ntu-hci-lab/SpinShot/README.md

# SpinShot

<div style="background-color: white; text-align: center;">
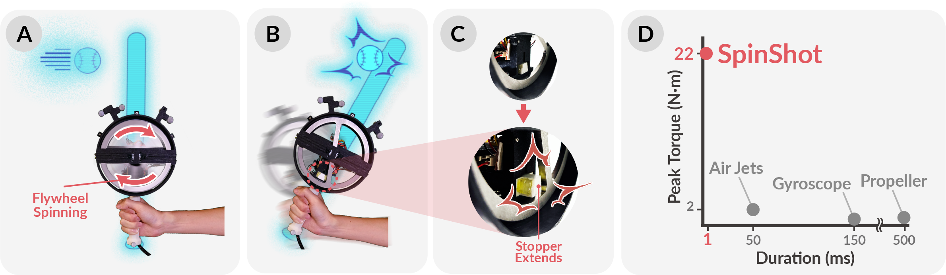
[picture p1: figures/Teaser.png]
    
</div>
