ntu-hci-lab/SpinShot/00_Hardware/Circuit/SpinShot_Circuit.png

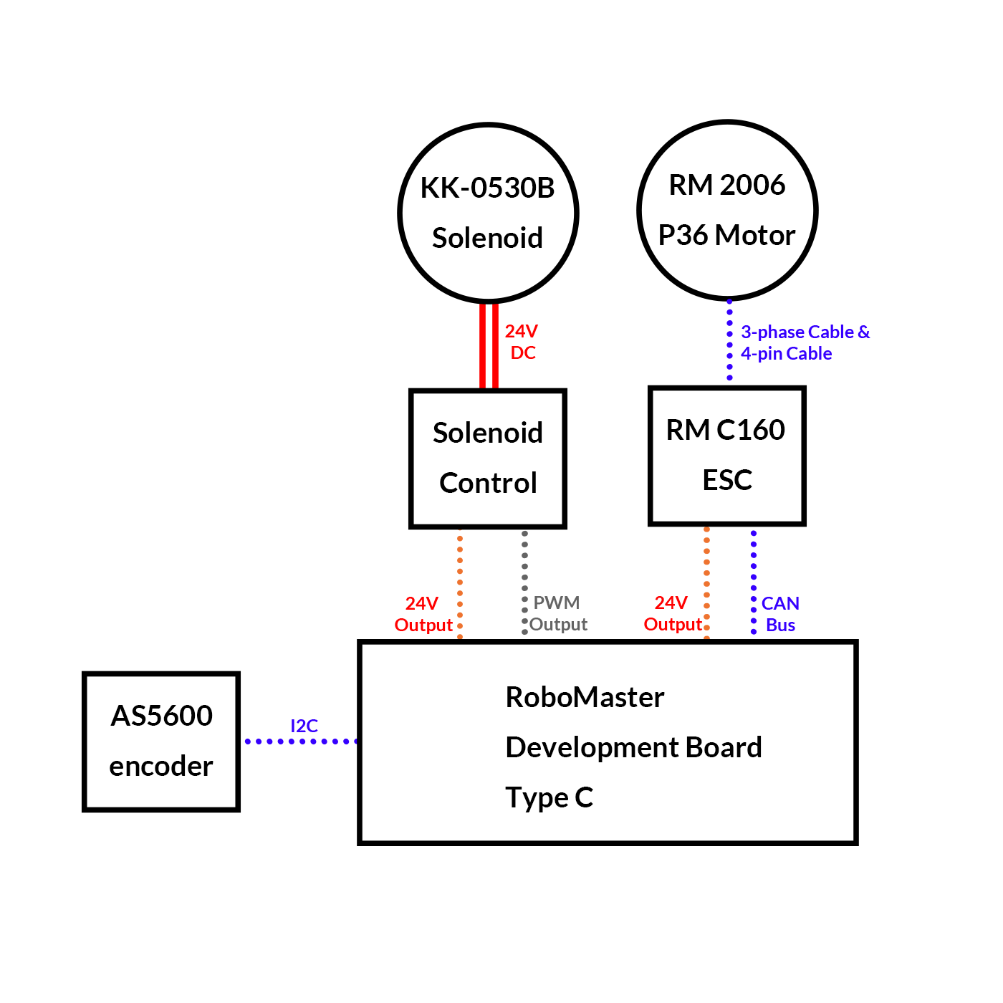
00_Hardware/Circuit/SpinShot_Circuit.png
