ntu-hci-lab/SpinShot/figures/Explosion.png

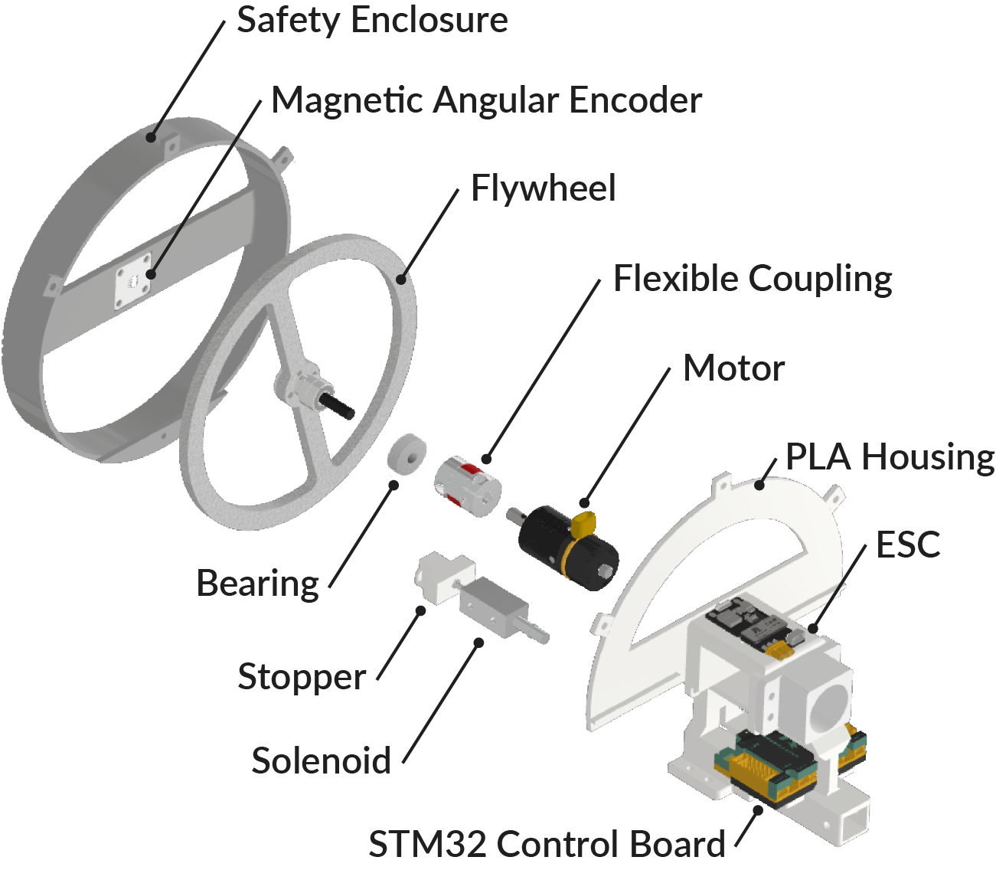
figures/Explosion.png
