ntu-hci-lab/SpinShot/00_Hardware/3D_Models/body/body.stl

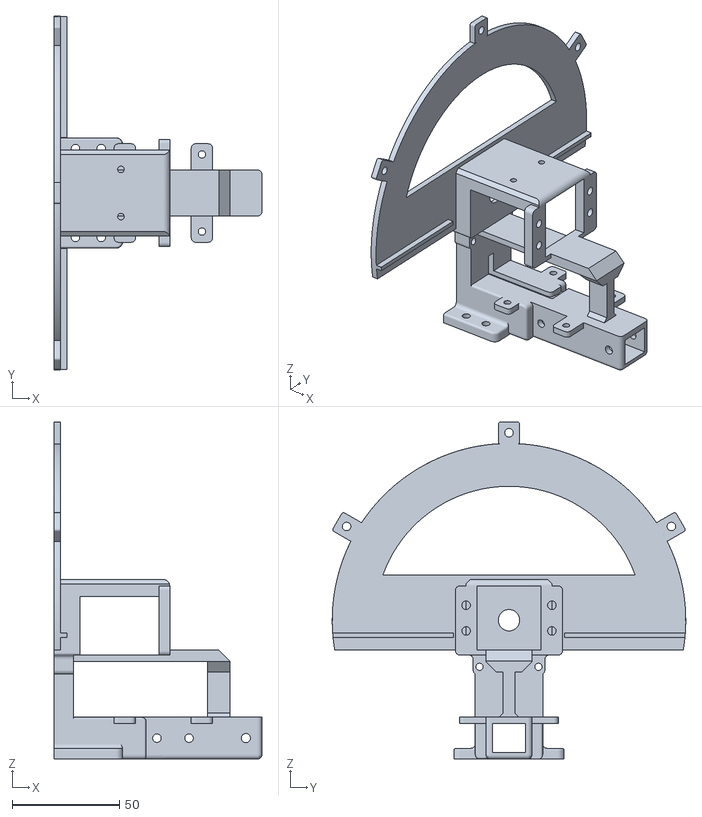
[picture p7: CAD file, 2024-06-13]
00_Hardware/3D_Models/body/body.stl
97.0 x 165.0 x 157.2
