ntu-hci-lab/SpinShot/00_Hardware/3D_Models/flywheel/flywheel_15cm.stl

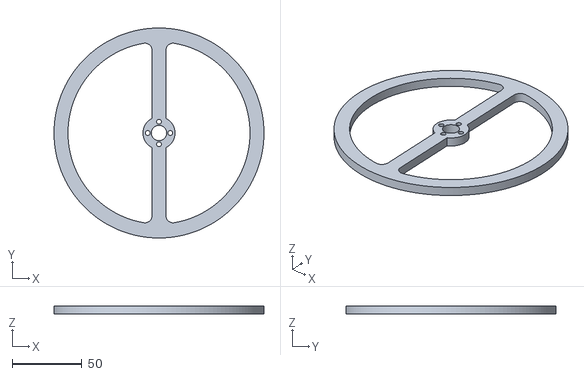
[picture p8: CAD file, 2024-06-13]
00_Hardware/3D_Models/flywheel/flywheel_15cm.stl
150.0 x 150.0 x 6.00
