ntu-hci-lab/SpinShot/00_Hardware/3D_Models/handle/long/handle_long.stl

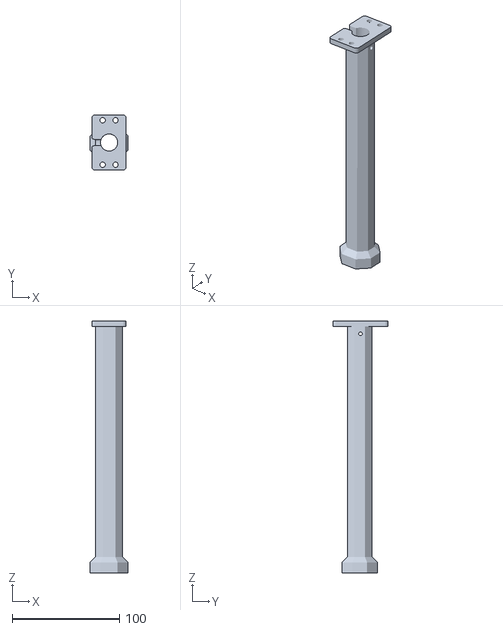
[picture p9: CAD file, 2024-06-13]
00_Hardware/3D_Models/handle/long/handle_long.stl
35.2 x 51.5 x 235.0
