ntu-hci-lab/SpinShot/00_Hardware/3D_Models/handle/short/handle_short.stl

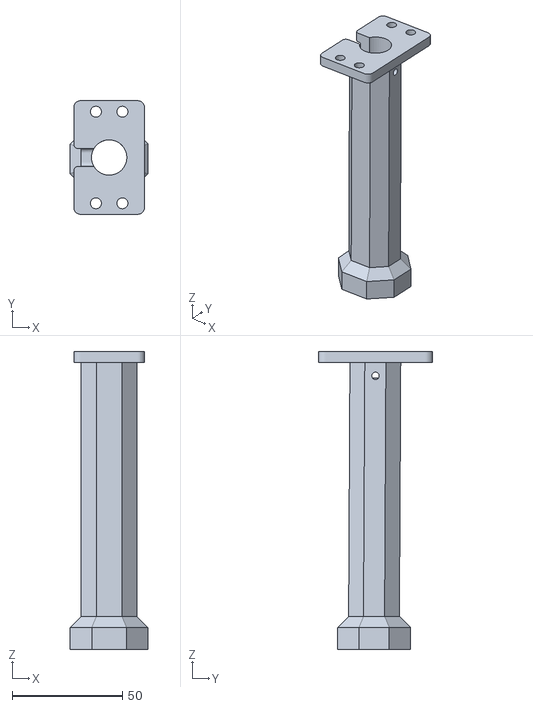
[picture p10: CAD file, 2024-06-13]
00_Hardware/3D_Models/handle/short/handle_short.stl
35.2 x 51.5 x 135.0
