ntu-hci-lab/SpinShot/00_Hardware/3D_Models/safty_enclosure/original/safty_enclosure.stl

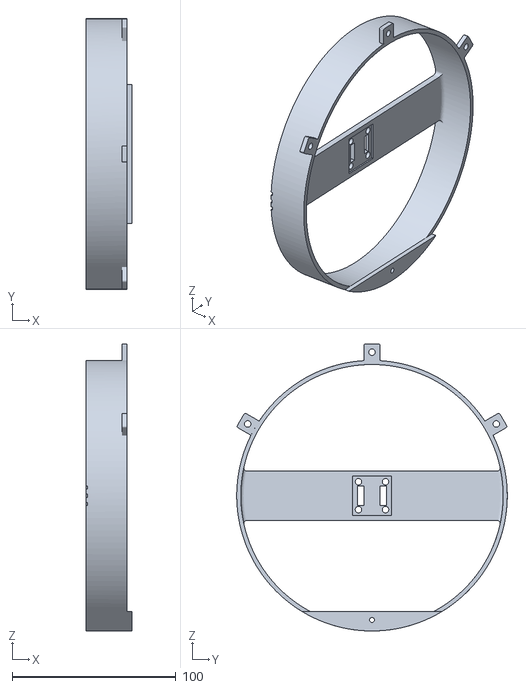
[picture p11: CAD file, 2024-06-13]
00_Hardware/3D_Models/safty_enclosure/original/safty_enclosure.stl
28.0 x 165.0 x 175.0
