ntu-hci-lab/SpinShot/00_Hardware/3D_Models/safty_enclosure/with_optiTrack_markers/enclosure_with_OptiTrack_markers.stl

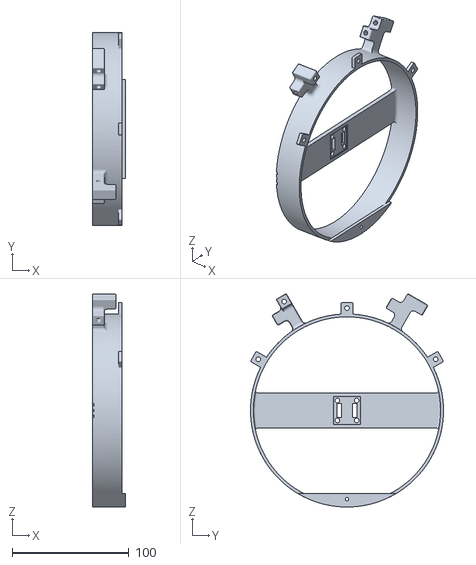
[picture p12: CAD file, 2024-06-13]
00_Hardware/3D_Models/safty_enclosure/with_optiTrack_markers/enclosure_with_OptiTrack_markers.stl
28.0 x 165.0 x 182.1
