ntu-hci-lab/SpinShot/00_Hardware/3D_Models/stopper/stopper.stl

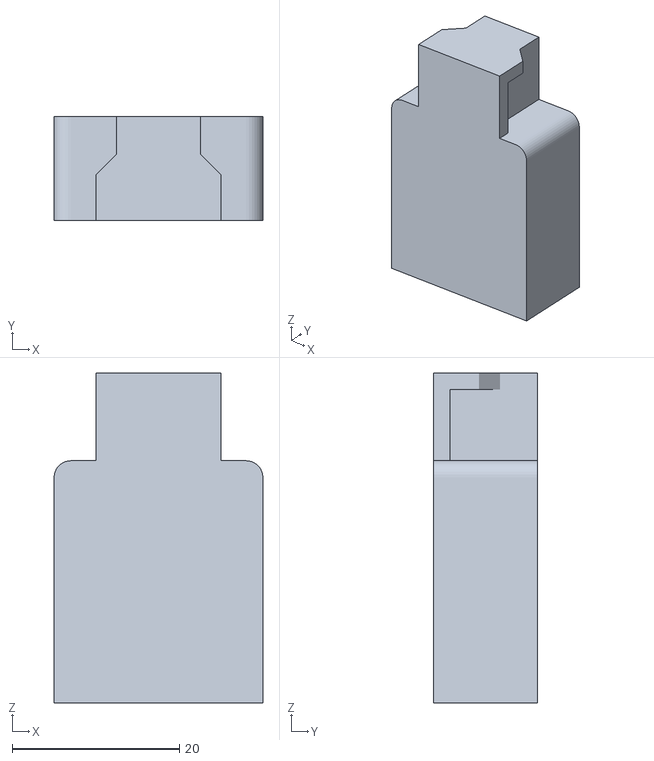
[picture p13: CAD file, 2024-06-13]
00_Hardware/3D_Models/stopper/stopper.stl
25.0 x 12.5 x 39.5
