ntu-hci-lab/SpinShot/(list of files, cad)

Other CAD files:
00_Hardware/3D_Models/body/Body.f3d
00_Hardware/3D_Models/body/Body.ipt
00_Hardware/3D_Models/flywheel/FLYWHEEL_15CM.DWG
00_Hardware/3D_Models/handle/long/handle_long.f3d
00_Hardware/3D_Models/handle/long/handle_long.ipt
00_Hardware/3D_Models/handle/short/handle_short.f3d
00_Hardware/3D_Models/handle/short/handle_short.ipt
00_Hardware/3D_Models/safty_enclosure/original/safty_enclosure.f3d
00_Hardware/3D_Models/safty_enclosure/original/safty_enclosure.ipt
00_Hardware/3D_Models/safty_enclosure/with_optiTrack_markers/enclosure_with_OptiTrack_markers.f3d
00_Hardware/3D_Models/safty_enclosure/with_optiTrack_markers/enclosure_with_OptiTrack_markers.ipt
00_Hardware/3D_Models/stopper/stopper.f3d
00_Hardware/3D_Models/stopper/stopper.ipt
