ntu-hci-lab/SpinShot/00_Hardware/3D_Models/flywheel/Flywheel.pdf

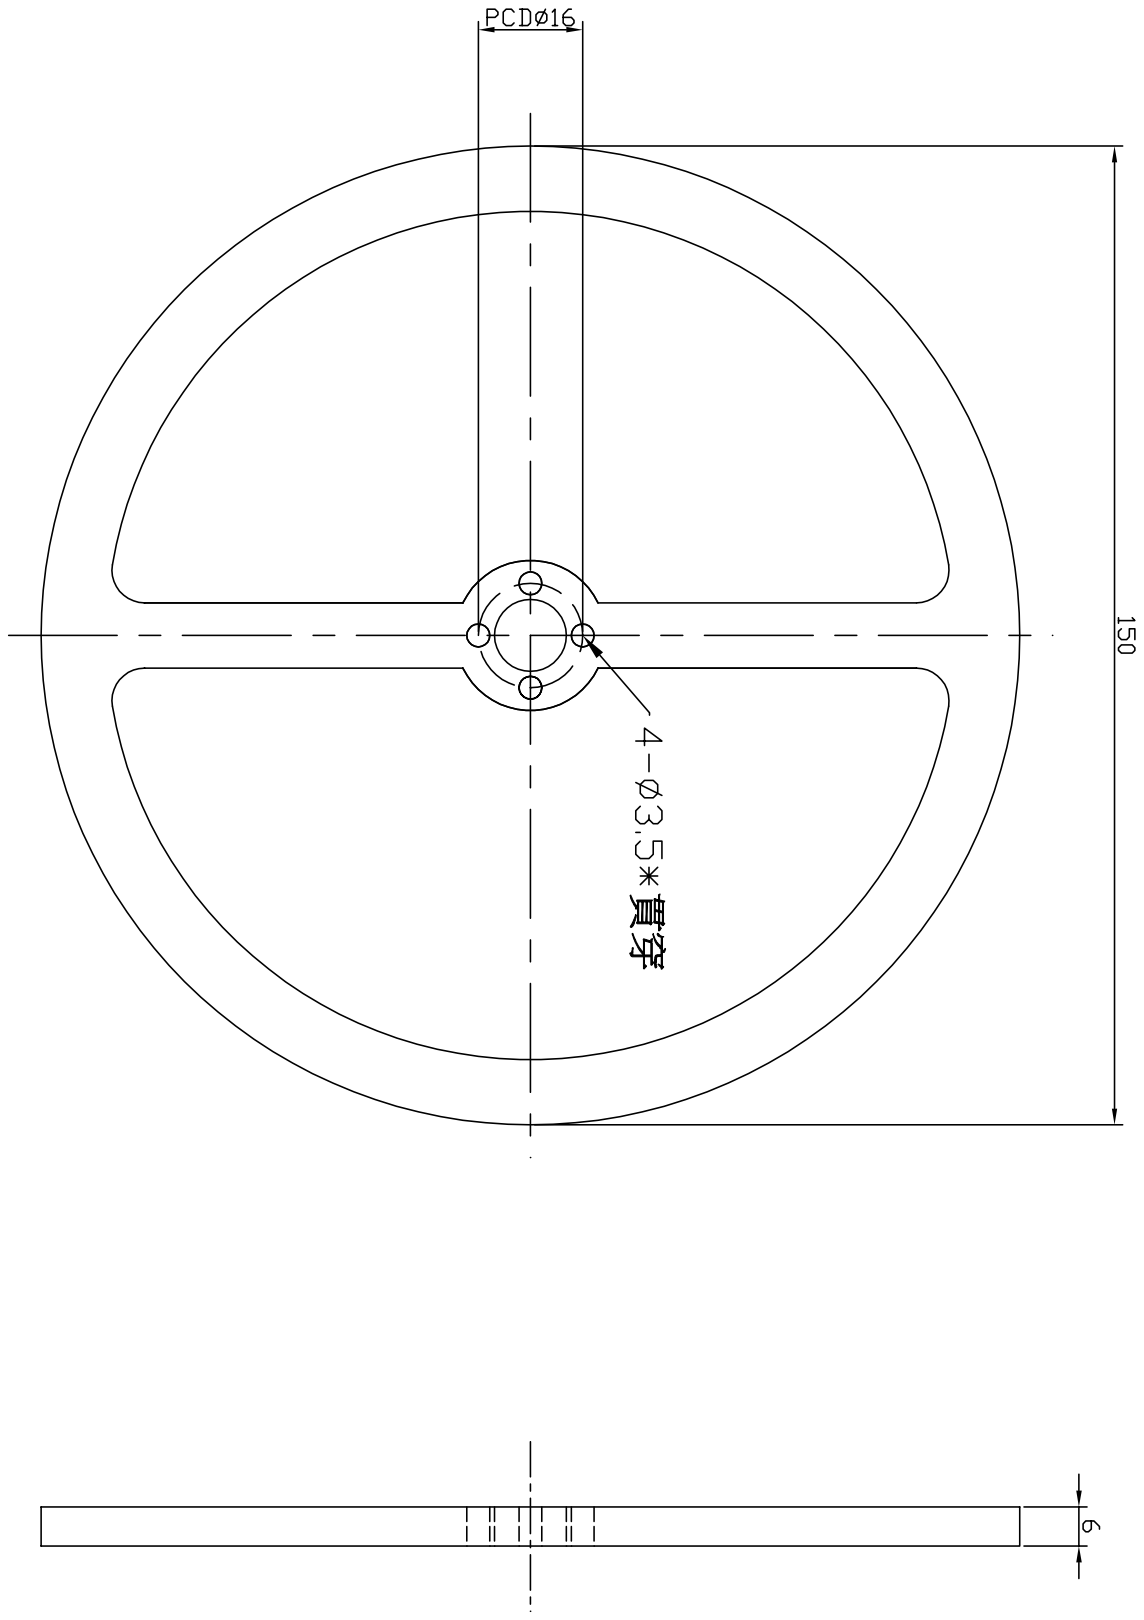
[picture p14: page 1]
