ntu-hci-lab/SpinShot/01_Firmware_STM32/SpinShot_STM32/SpinShot.ioc

Mcu.UserName=STM32F407IGHx
PA11.Signal=USB_OTG_FS_DM
PA12.Signal=USB_OTG_FS_DP
PA13.Signal=SYS_JTMS-SWDIO
PA14.Signal=SYS_JTCK-SWCLK
PC6.Signal=S_TIM8_CH1
PD0.Signal=CAN1_RX
PD1.Signal=CAN1_TX
PE11.Signal=S_TIM1_CH2
PE13.Signal=S_TIM1_CH3
PE14.Signal=S_TIM1_CH4
PE9.Signal=S_TIM1_CH1
PF0.Signal=I2C2_SDA
PF1.Signal=I2C2_SCL
PH0-OSC_IN.Signal=RCC_OSC_IN
PH1-OSC_OUT.Signal=RCC_OSC_OUT
PI6.Signal=S_TIM8_CH2
PI7.Signal=S_TIM8_CH3
