ntu-hci-lab/SpinShot/01_Firmware_STM32/SpinShot_STM32/application/commend_processor.c

#include "commend_processor.h"
#include "main.h"
#include <string.h>
#include <stdlib.h>

extern char* commends[50];
extern int commend_count;
extern int commend_head;
extern enum Status status;
extern int16_t target_rpm;
extern int16_t impact_mode;
extern bool_t impact_pending;
extern int16_t shift_angle;
extern int16_t message_type;
extern uint32_t test_value;
