ntu-hci-lab/SpinShot/(commit log)

2024-06-13 Add files via upload
    Add SpinShot Hardware Designs
    [Body.f3d, Body.ipt, FLYWHEEL_15CM.DWG, body.stl, enclosure_with_OptiTrack_markers.f3d, enclosure_with_OptiTrack_markers.ipt, enclosure_with_OptiTrack_markers.stl, flywheel_15cm.stl]
2024-06-13 add circuit placement
2024-06-14 add software example codes
    [Body.f3d, Body.ipt, FLYWHEEL_15CM.DWG, body.stl, enclosure_with_OptiTrack_markers.f3d, enclosure_with_OptiTrack_markers.ipt, enclosure_with_OptiTrack_markers.stl, flywheel_15cm.stl]
